sq8vps/vp-digi/(threads)

Thread 11 (2022-10-01):

300baud functionality

SQ9MDD, 2022-10-01:
Request to be able to change the operating speed to 300baud, which will allow operation on HF bands.
The tone shift is 200 Hz rather than the 1000 Hz used in 1200 baud packet.

sq8vps, 2023-10-05:
300 Baud Bell 103 modem added in version 2.0.0.

Closed 2023-10-05.

Thread 18 (2023-08-14):

Add precise measured current (mA) values to readme

DeflateAwning, 2023-08-14:
Can you measure the min and max current draw of this device? We're considering using it for a cubesat project, where we have very tight power draw requirements

sq8vps, 2023-08-16:
The Blue Pill has no current measurement circuit built-in, but it is perfectly possible to include a shunt resistor in series with power supply and measure voltage drop with some op-amp. Currently I'm rewriting the code and voltage measurement and embedding it in beacon is on my to-do list and will be added in next release.

DeflateAwning, 2023-09-12:
The microcontroller uses about 40-50 mA in our testing, if that's a piece of information you want to add to the documentation

sq8vps, 2025-08-10:
Added, thank you.

Closed 2025-08-10.

Thread 20 (2023-08-14):

Build error: `multiple definition of 'ax25Cfg'`

DeflateAwning, 2023-08-14:
I'm getting the following build error after converting to STM32CubeIDE v1.13.0:

```
C:/ST/STM32CubeIDE_1.13/STM32CubeIDE/plugins/com.st.stm32cube.ide.mcu.externaltools.gnu-tools-for-stm32.11.3.rel1.win32_1.1.0.202305231506/tools/bin/../lib/gcc/arm-none-eabi/11.3.1/../../../../arm-none-eabi/bin/ld.exe: ./Src/beacon.o:C:/Users/me/vp-digi/Debug/../Inc/ax25.h:45: multiple definition of `ax25Cfg'; ./Src/ax25.o:C:/Users/me/vp-digi/Debug/../Inc/ax25.h:45: first defined here
```

Any idea what's going on?

I'm curious why those variables are declared in the headers and not in the C files (and then declared as `extern`s)?

sq8vps, 2023-08-16:
There compiler is probably different and it does not allow such things. I am refactoring the code to get rid of these bugs

Closed 2023-08-30.

Thread 24 (2023-08-21):

Receiving commands appears to break when using a CrLf (\r\n) line ending

DeflateAwning, 2023-08-21:
Steps to reproduce:

1. Turn on device, flash. connect to UART1 with a 9600 uart-to-usb converter. Using RealTerm.
2. Send `monitor\n`, where `\n` means the newline character (and not those literal characters).
3. Send `version\n`. Everything works.
4. Send `version\n\r`. Everything works fine. This is a weird one that probably rarely happens.
5. Send `version\r`. Everything works fine.
6. Send `version\r\n`. Observe no response. Observe that device goes unresponsive.

It appears that after step 5, the device requires a reboot to function.

This isn't the worst bug, but thought it was worth pointing out. In the README or on your website, you should mention the expected EOL character (esp. if you don't fix this behaviour).

sq8vps, 2023-08-30:
Resolved in 1.3.0, or at least I was unable to reproduce the issue

Closed 2023-08-30.

Thread 34 (2023-10-13):

Add voltage measurement and coulomb counter

9M2IBR, 2023-10-13:
Hi, can you add voltage measurement and coulomb counter So it can transmit the Value in beacon. Its can very usefull for solar powered digipeater.

sq8vps, 2024-05-16:
I believe you would like to have a voltage measurement and some kind of battery drain measurement?

Thread 35 (2023-10-15):

Missing rs.h - vp-digi failed to build

t52ta6ek, 2023-10-15:
Greetings!

Using STM32 IDE 1.13.2, Windows 10.
Cloned repository and imported into IDE
When attempting to reproduce the build, fx25.c reports failed to compile because of missing header file rs.h .

arm-none-eabi-gcc "../Core/Src/stm32f1xx_hal_msp.c" -mcpu=cortex-m3 -std=gnu11 -g -DDEBUG -DENABLE_FX25 -DUSE_HAL_DRIVER -DSTM32F103xB -c -I../Core/Inc -I../Drivers/STM32F1xx_HAL_Driver/Inc -I../Drivers/STM32F1xx_HAL_Driver/Inc/Legacy -I../Drivers/CMSIS/Device/ST/STM32F1xx/Include -I../Drivers/CMSIS/Include -I../lwfec -I../USB_DEVICE/App -I../USB_DEVICE/Target -I../Middlewares/ST/STM32_USB_Device_Library/Core/Inc -I../Middlewares/ST/STM32_USB_Device_Library/Class/CDC/Inc -Og -ffunction-sections -fdata-sections -Wall -fstack-usage -fcyclomatic-complexity -MMD -MP -MF"Core/Src/stm32f1xx_hal_msp.d" -MT"Core/Src/stm32f1xx_hal_msp.o" --specs=nano.specs -mfloat-abi=soft -mthumb -o "Core/Src/stm32f1xx_hal_msp.o"
../Core/Src/fx25.c:24:10: fatal error: rs.h: No such file or directory
   24 | #include "rs.h"
      |          ^~~~~~
compilation terminated.

sq8vps, 2023-10-16:
Did you execute
```
git submodule init
git submodule update
```
before compilation, as specified in readme?

t52ta6ek, 2023-10-16:
Mea culpa! RTFM.
Build successful after completing git submodule steps... ;-)
tnx!

Closed 2023-10-16.

Thread 44 (2025-06-15):

AIOC build - USB serial device cannot start

tristanmoney, 2025-06-15:
Hi Piotr,

I am trying to test the AIOC with VP-Digi and I was able to build and flash but get the following error with the serial port:

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

Any idea why? I assume this USB serial port can to be used to configure VP-Digi or use it as a KISS TNC, just like like blue pill.

Thanks,

Tristan

tristanmoney, 2025-08-12:
I have version 1.11.5 of the STM32CubeF3 drivers and USB device library, if that matters. I think I tried an older version back in June but wasn't able to get it working.

Thread 45 (2025-07-06):

ax25.c broken for FX25

hiperiondev, 2025-07-06:
When enable FX25 in line 532:
	if(rx->rx != RX_STAGE_FX25_FRAME)
	{

this if have not close brace in the rest of code.

Gethub-prog, 2025-07-12:
Aprs using Baofeng 5RH pro can't be digitized on vpdigi, raw packets come in, but can't be digitized... I don't know if this is from the Baofeng firmware or from vpdigi

sq8vps, 2025-08-10:
Hi,
I'm pretty sure there is a closing bracket in line 614, which corresponds to the opening bracket in line 533 (FX.25) and line 599 (non-FX.25). Does this cause errors during compilation?
