sq8vps/vp-digi/Core/Src/main.c

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
/* Includes ------------------------------------------------------------------*/
#include "main.h"
#include "usb_device.h"
#include "gpio.h"

/* USER CODE BEGIN Includes */
#include <stdint.h>
#include "modem.h"
#include "ax25.h"
#include "digipeater.h"
#include "common.h"
#include "drivers/watchdog.h"
#include "beacon.h"
#include "terminal.h"
#include "config.h"
#include "uart.h"
#include "drivers/usb.h"
#include "kiss.h"
#ifdef ENABLE_FX25
#include "fx25.h"
#endif
/* USER CODE END Includes */


void SystemClock_Config(void);
/* USER CODE BEGIN 0 */
/**
 * @brief Handle received frame
 */
static void handleFrame(void)
{
	uint8_t modemBitmap = Ax25GetReceivedFrameBitmap(); // store states
	Ax25ClearReceivedFrameBitmap();

	uint8_t *buf;
	uint16_t size = 0;
	int8_t peak = 0;
	int8_t valley = 0;
	uint8_t signalLevel = 0;
	uint8_t fixed = 0;

	while (Ax25ReadNextRxFrame(&buf, &size, &peak, &valley, &signalLevel, &fixed))
	{
		if(DigiCheckFilter(&buf[7]) || !GeneralConfig.kissFilter)
			TermSendToAllN(MODE_KISS, buf, size);

		if ((UartUsb.mode == MODE_MONITOR)
#ifdef BLUE_PILL
		|| (Uart1.mode == MODE_MONITOR) 
		|| (Uart2.mode == MODE_MONITOR)
#endif
		)
		{
			char str[20];
			char *pstr = str;

			if(signalLevel > 70)
			{
				TermSendToAll(MODE_MONITOR, "\r\nInput level too high! Please reduce so most stations are around 30-50%.\r\n");
			}
			else if (signalLevel < 5)
			{
				TermSendToAll(MODE_MONITOR, "\r\nInput level too low! Please increase so most stations are around 30-50%.\r\n");
			}
#ifdef ENABLE_FX25
			if(fixed != AX25_NOT_FX25)
				TermSendToAll(MODE_MONITOR, "(FX.25)");
			else
#endif
				TermSendToAll(MODE_MONITOR, "(AX.25)");
			TermSendToAll(MODE_MONITOR, " Frame received [");
			for(uint8_t i = 0; i < ModemGetDemodulatorCount(); i++)
			{
				if (modemBitmap & (1 << i))
				{
					enum ModemPrefilter m = ModemGetFilterType(i);
					switch (m)
					{
						case PREFILTER_PREEMPHASIS:
							*pstr++ = 'P';
							break;
						case PREFILTER_DEEMPHASIS:
							*pstr++ = 'D';
							break;
						case PREFILTER_FLAT:
							*pstr++ = 'F';
							break;
						case PREFILTER_NONE:
							*pstr++ = 'N';
							break;
					}
				}
				else
					*pstr++ = '_';
			}
			*pstr++ = '\0';
			TermSendToAll(MODE_MONITOR, str);
			TermSendToAll(MODE_MONITOR, "], ");
#ifdef ENABLE_FX25
			if(fixed != AX25_NOT_FX25)
			{
				IntToStr(fixed, str);
				TermSendToAll(MODE_MONITOR, str);
				TermSendToAll(MODE_MONITOR, " bytes fixed, ");
			}
#endif
			TermSendToAll(MODE_MONITOR, "signal level ");
			IntToStr(signalLevel, str);
			TermSendToAll(MODE_MONITOR, str);
			TermSendToAll(MODE_MONITOR, "% (");
			IntToStr(peak, str);
			TermSendToAll(MODE_MONITOR, str);
			TermSendToAll(MODE_MONITOR, "%/");
			IntToStr(valley, str);
			TermSendToAll(MODE_MONITOR, str);
			TermSendToAll(MODE_MONITOR, "%): ");

			SendTNC2(buf, size);
			TermSendToAll(MODE_MONITOR, "\r\n");
		}

		DigiDigipeat(buf, size);
	}
}
/* USER CODE END 0 */

/**
  * @brief  The application entry point.
  * @retval int
  */
int main(void)
{

  /* MCU Configuration--------------------------------------------------------*/

  /* Reset of all peripherals, Initializes the Flash interface and the Systick. */
  HAL_Init();

  /* Configure the system clock */
  SystemClock_Config();

  /* USER CODE BEGIN SysInit */
	HAL_SetTickFreq(VPDIGI_HAL_TICK_FREQUENCY);

	USB_FORCE_REENUMERATION();
  /* USER CODE END SysInit */

  /* Initialize all configured peripherals */
  MX_GPIO_Init();
  MX_USB_DEVICE_Init();
  /* USER CODE BEGIN 2 */
	WdogInit(); // initialize watchdog

	memset(BeaconConfig, 0, sizeof(BeaconConfig));
	memset(&Ax25Config, 0, sizeof(Ax25Config));
	memset(&ModemConfig, 0, sizeof(ModemConfig));
	memset(&DigiConfig, 0, sizeof(DigiConfig));

	// set some initial values in case there is no configuration saved in memory
#ifdef BLUE_PILL
	Uart1.config.baudrate = 9600;
	Uart1.config.defaultMode = MODE_KISS;
	Uart2.config.baudrate = 9600;
	Uart2.config.defaultMode = MODE_KISS;
#endif
	UartUsb.config.defaultMode = MODE_KISS;
	ModemConfig.usePWM = 1; //use PWM in non-AIOC versions
	ModemConfig.flatAudioIn = 0; //no flat audio
	ModemConfig.pttOutput = 0; //primary PTT in AIOC versions
	ModemConfig.txLevel = 100; //100% - only in AIOC versions
	Ax25Config.quietTime = 300;
	Ax25Config.txDelayLength = 300;
	Ax25Config.txTailLength = 30;
	Ax25Config.fx25 = 0;
	DigiConfig.dupeTime = 30;

	ConfigRead();

	ModemInit();
	Ax25Init();
#ifdef ENABLE_FX25
	Fx25Init();
#endif

	DigiInitialize();

#ifdef BLUE_PILL
	UartInit(&Uart1, UART_LL_UART1_STRUCTURE, Uart1.config.baudrate);
	UartConfig(&Uart1, 1);
	UartInit(&Uart2, UART_LL_UART2_STRUCTURE, Uart2.config.baudrate);
	UartConfig(&Uart2, 1);
#endif

	UartInit(&UartUsb, NULL, 1);
	UartConfig(&UartUsb, 1);

	BeaconInit();
  /* USER CODE END 2 */

  /* Infinite loop */
  /* USER CODE BEGIN WHILE */
	while (1)
	{
    /* USER CODE END WHILE */

    /* USER CODE BEGIN 3 */
		WdogReset();

		if (Ax25GetReceivedFrameBitmap())
			handleFrame();

		DigiUpdateState(); // update digipeater state

		Ax25TransmitBuffer(); // transmit buffer (will return if nothing to be transmitted)

		Ax25TransmitCheck(); // check for pending transmission request

		if (UartUsb.rxType != DATA_NOTHING)
		{
			TermHandleSpecial(&UartUsb);
			if (UartUsb.rxType == DATA_KISS)
			{
				KissProcess(&UartUsb);
			}
			else if (UartUsb.rxType != DATA_USB)
			{

				TermParse(&UartUsb);
				UartClearRx(&UartUsb);
			}
			// previously there was just UartUsb.rxType = DATA_NOTHING, which could introduce deadlocks
			// assume that we were here, because rxType was DATA_USB, but in the meantime a new USB interrupt fired and rxType changed to DATA_KISS,
			// and the KISS parsing handler would set kissProcessingOngoing to 1. Then, we change rxType to DATA_NOTHING and are left in an incorrect scenario, when
			// rxType is DATA_NOTHING, and kissProcessingOngoing is 1, which is a clear deadlock, because then DATA_KISS can never be reached again.
			// That's why it is necessary to disable interrupts and check one more time for rxType before clearing it
			else
			{
				__disable_irq();
				if (UartUsb.rxType == DATA_USB)
					UartUsb.rxType = DATA_NOTHING;
				__enable_irq();
			}
		}
#ifdef BLUE_PILL
		if (Uart1.rxType != DATA_NOTHING)
		{
			if (Uart1.rxType == DATA_KISS)
			{
				KissProcess(&Uart1);
			}
			else
			{
				TermParse(&Uart1);
				UartClearRx(&Uart1);
			}
		}
		if (Uart2.rxType != DATA_NOTHING)
		{
			if (Uart2.rxType == DATA_KISS)
			{
				KissProcess(&Uart2);
			}
			else
			{
				TermParse(&Uart2);
				UartClearRx(&Uart2);
			}
		}
#endif

		BeaconCheck(); // check beacons

		if (HAL_GetTick() > 0xFFFFF000) // going to wrap around soon - hard reset the device
			NVIC_SystemReset();
	}
  /* USER CODE END 3 */
}

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
