sq8vps/vp-digi/Core/Src/modem.c

/*
Copyright 2020-2026 Piotr Wilkon
This file is part of VP-Digi.

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
You should have received a copy of the GNU General Public License
along with VP-Digi.  If not, see <http://www.gnu.org/licenses/>.
*/

#include <string.h>
#include <math.h>
#include "modem.h"
#include <stdlib.h>
#include <stdbool.h>
#include "ax25.h"
#include "common.h"
#include "drivers/modem_ll.h"
#include "filter.h"

/*
 * Configuration for PLL-based data carrier detection
 * 1. MAXPULSE - the maximum value of the DCD pulse counter. Higher values allow for more stability when a correct signal is detected,
 * but introduce a delay when releasing DCD
 * 2. THRES - the threshold value of the DCD pulse counter. When reached the input signal is assumed to be valid. Higher values mean more immunity to noise,
 * but introduce delay when setting DCD
 * 3. MAXPULSE and THRES difference sets the DCD "inertia" so that the DCD state won't change rapidly when a valid signal is present
 * 4. INC is the DCD pulse counter incrementation value when symbol changes near the PLL counter zero
 * 5. DEC is the DCD pulse counter decrementation value when symbol changes too far from PLL counter zero
 * 6. TUNE is the PLL counter tuning coefficient. It is applied when there is a symbol change (as the symbol change should occur when the PLL counter crosses zero)
 *
 * [       DCD OFF    *      |    DCD ON   ]
 * 0               COUNTER THRES        MAXPULSE
 *        <-DEC INC->
 *
 * The DCD mechanism is described in demodulate().
 * All values were selected by trial and error
 */
#define DCD1200_MAXPULSE 60
#define DCD1200_THRES 20
#define DCD1200_INC 2
#define DCD1200_DEC 1
#define DCD1200_TUNE 0.74f

#define DCD9600_MAXPULSE 60
#define DCD9600_THRES 40
#define DCD9600_INC 1
#define DCD9600_DEC 1
#define DCD9600_TUNE 0.74f

#define DCD300_MAXPULSE 80
#define DCD300_THRES 20
#define DCD300_INC 4
#define DCD300_DEC 1
#define DCD300_TUNE 0.74f

#define N1200 8 //samples per symbol @ fs=9600, oversampling = 38400 Hz
#define N9600 4 //fs=38400, oversampling = 153600 Hz
#define N300 32 //fs=9600, oversampling = 38400 Hz
#define NMAX 32 //keep this value equal to the biggest Nx

#define PLL1200_STEP (((uint64_t)1 << 32) / N1200) //PLL tick increment value
#define PLL9600_STEP (((uint64_t)1 << 32) / N9600)
#define PLL300_STEP (((uint64_t)1 << 32) / N300)

#define PLL1200_LOCKED_TUNE 0.74f
#define PLL1200_NOT_LOCKED_TUNE 0.50f
#define PLL9600_LOCKED_TUNE 0.89f
#define PLL9600_NOT_LOCKED_TUNE 0.50f //I have 0.67 noted somewhere as possibly better value
#define PLL300_LOCKED_TUNE 0.74f
#define PLL300_NOT_LOCKED_TUNE 0.50f

#define AMP_TRACKING_ATTACK 0.16f //0.16
#define AMP_TRACKING_DECAY 0.00004f //0.00004


#define DAC_SINE_SIZE 128 //DAC sine table size

#define PLL_TUNE_BITS 8 //number of bits when tuning PLL to avoid floating point operations

struct ModemDemodConfig ModemConfig;

static uint8_t N; //samples per symbol
static enum ModemTxTestMode txTestState; //current TX test mode
static uint8_t demodCount; //actual number of parallel demodulators
static sample_t dacSine[DAC_SINE_SIZE]; //sine samples for DAC
static uint8_t dacSineIdx; //current sine sample index
static volatile uint16_t samples[MODEM_LL_OVERSAMPLING_FACTOR]; //very raw received samples, filled directly by DMA
static uint8_t currentSymbol; //current symbol for NRZI encoding
static uint8_t scrambledSymbol; //current symbol after scrambling
static float markFreq; //mark frequency
static float spaceFreq; //space frequency
static float baudRate; //baudrate
static uint8_t markStep; //mark timer step
static uint8_t spaceStep; //space timer step
static uint16_t baudRateStep; //baudrate timer step
static sample_t coeffHiI[NMAX], coeffLoI[NMAX], coeffHiQ[NMAX], coeffLoQ[NMAX]; //correlator IQ coefficients
static uint8_t dcd = 0; //multiplexed DCD state from both demodulators
static uint32_t lfsr = 0xFFFFF; //LFSR for 9600 Bd
static int32_t adcBias = 4095; //ADC bias after decimation


struct DemodState
{
	uint8_t rawSymbols; //raw, unsynchronized symbols
	uint8_t syncSymbols; //synchronized symbols

	enum ModemPrefilter prefilter;
	struct Filter bpf;
	sample_t correlatorSamples[NMAX];
	uint8_t correlatorSamplesIdx;
	struct Filter lpf;

	uint8_t dcd : 1; //DCD state

	int32_t pll; //bit recovery PLL counter
	int32_t pllStep;
	int32_t pllLockedTune;
	int32_t pllNotLockedTune;

	int32_t dcdPll; //DCD PLL main counter
	uint8_t dcdLastSymbol; //last symbol for DCD
	uint16_t dcdCounter; //DCD "pulse" counter (incremented when RX signal is correct)
	uint16_t dcdMax;
	uint16_t dcdThres;
	uint16_t dcdInc;
	uint16_t dcdDec;
	int32_t dcdTune;

	sample_t peak;
	sample_t valley;
};

static struct DemodState demodState[MODEM_MAX_DEMODULATOR_COUNT];

static void decode(uint8_t symbol, uint8_t demod);
static sample_t demodulate(sample_t sample, struct DemodState *dem);
static void setPtt(bool state);


float ModemGetBaudrate(void)
{
	return baudRate;
}

uint8_t ModemGetDemodulatorCount(void)
{
	return demodCount;
}

uint8_t ModemDcdState(void)
{
	return dcd;
}

uint8_t ModemIsTxTestOngoing(void)
{
	if(txTestState != TEST_DISABLED)
		return 1;

	return 0;
}

void ModemGetSignalLevel(uint8_t modem, int8_t *peak, int8_t *valley, uint8_t *level)
{
#ifndef USE_FPU
	*peak = (100 * (int32_t)demodState[modem].peak) >> 12;
	*valley = (100 * (int32_t)demodState[modem].valley) >> 12;
	*level = (100 * (int32_t)(demodState[modem].peak - demodState[modem].valley)) >> 13;
#else
	*peak = 100.f * demodState[modem].peak;
	*valley = 100.f * demodState[modem].valley;
	*level = 50.f * (demodState[modem].peak - demodState[modem].valley);
#endif
}

enum ModemPrefilter ModemGetFilterType(uint8_t modem)
{
	return demodState[modem].prefilter;
}

/**
 * @brief Set DCD LED
 * @param[in] state False - OFF, true - ON
 */
static void setDcd(bool state)
{
	if(state)
		MODEM_LL_DCD_LED_ON();
	else
		MODEM_LL_DCD_LED_OFF();
}

static inline uint8_t descramble(uint8_t in)
{
	//G3RUH descrambling (x^17+x^12+1)
	uint8_t bit = ((lfsr & 0x10000) > 0) ^ ((lfsr & 0x800) > 0) ^ (in > 0);

	lfsr <<= 1;
	lfsr |= in;
	return bit;
}

static inline uint8_t scramble(uint8_t in)
{
	//G3RUH scrambling (x^17+x^12+1)
	uint8_t bit = ((lfsr & 0x10000) > 0) ^ ((lfsr & 0x800) > 0) ^ (in > 0);

	lfsr <<= 1;
	lfsr |= bit;
	return bit;
}

/**
 * @brief ISR for demodulator
 */
void MODEM_LL_DMA_INTERRUPT_HANDLER(void)
{
	 if(MODEM_LL_DMA_TRANSFER_COMPLETE_FLAG)
	 {
		 MODEM_LL_DMA_CLEAR_TRANSFER_COMPLETE_FLAG();

		//each sample is 12 bits, output sample is 13 bits (non-FPU)
		sample_t sample = (sample_t)((int32_t)((samples[0] + samples[1] + samples[2] + samples[3]) >> 1) - adcBias); //calculate input sample (decimation)
#ifdef USE_FPU
		sample *= (1.f / 4096.f);
#endif

		bool partialDcd = false;

		for(uint8_t i = 0; i < demodCount; i++)
		{
			uint8_t symbol = (demodulate(sample, (struct DemodState*)&demodState[i]) > 0); //demodulate sample
			decode(symbol, i); //recover bits, decode NRZI and call higher level function
			if(demodState[i].dcd)
				partialDcd = true;
		}

		if(partialDcd) //DCD on any of the demodulators
		{
			dcd = 1;
			setDcd(true);
		}
		else //no DCD on both demodulators
		{
			dcd = 0;
			setDcd(false);
		}
	}
}

/**
 * @brief ISR for pushing DAC samples
 */
 void MODEM_LL_DAC_INTERRUPT_HANDLER(void)
 {
	 MODEM_LL_DAC_TIMER_CLEAR_INTERRUPT_FLAG;

 	sample_t sample;

 	if(ModemConfig.modem == MODEM_9600)
 	{
#ifdef USE_FPU
 		sample = (sample_t)(scrambledSymbol ? 1.f : -1.f);
#else
		sample = (sample_t)(scrambledSymbol ? MODEM_LL_DAC_MAX : 0);
#endif
 		sample = filter(&demodState[0].lpf, sample);
 	}
 	else
 	{
 		sample = dacSine[dacSineIdx];
 		dacSineIdx++;
 		dacSineIdx %= DAC_SINE_SIZE;
 	}

#ifdef AIOC
 	sample = (sample * (sample_t)ModemConfig.txLevel) / (sample_t)100;
#endif

 	int32_t dacSample;
#ifdef USE_FPU
 	dacSample = ((sample + 1.f) * 0.5f) * (sample_t)MODEM_LL_DAC_MAX;
#else
 	dacSample = sample;
#endif

 	if(dacSample < 0)
 		dacSample = 0;
 	else if(dacSample > MODEM_LL_DAC_MAX)
 		dacSample = MODEM_LL_DAC_MAX;

 	MODEM_LL_DAC_PUT_VALUE(dacSample);
}


/**
 * @brief ISR for baudrate generator timer. NRZI encoding is done here.
 */
 void MODEM_LL_BAUDRATE_TIMER_INTERRUPT_HANDLER(void)
 {
	 MODEM_LL_BAUDRATE_TIMER_CLEAR_INTERRUPT_FLAG();

 	if(txTestState == TEST_DISABLED) //transmitting normal data
 	{
 		if(Ax25GetTxBit() == 0) //get next bit and check if it's 0
 		{
 			currentSymbol ^= 1; //change symbol - NRZI encoding
 		}
 		//if 1, no symbol change
 	}
 	else //transmit test mode
 	{
 		if(ModemConfig.modem == MODEM_9600)
 		{
 			scrambledSymbol ^= 1;
 			return;
 		}
 		currentSymbol ^= 1; //change symbol
 	}

 	if(ModemConfig.modem == MODEM_9600)
 	{
 		scrambledSymbol = scramble(currentSymbol);
 	}
 	else
 	{
 	 	MODEM_LL_DAC_TIMER_SET_CURRENT_VALUE(0);
 		if(currentSymbol)
 		{
 			MODEM_LL_DAC_TIMER_SET_RELOAD_VALUE(spaceStep);
 		}
 		else
 		{
 			MODEM_LL_DAC_TIMER_SET_RELOAD_VALUE(markStep);
 		}
 	}

}

/**
 * @brief Demodulate received sample (4x oversampling)
 * @param[in] sample Received sample, not more than 13 bits (non-FPU)
 * @param[in] *dem Demodulator state
 * @return Current tone (0 or 1)
 */
static sample_t demodulate(sample_t sample, struct DemodState *dem)
{
	//input signal amplitude tracking
#ifndef USE_FPU
	if(sample > dem->peak)
	{
		dem->peak += (((int32_t)(AMP_TRACKING_ATTACK * (float)32768) * (int32_t)(sample - dem->peak)) >> 15);
	}
	else
	{
		dem->peak += (((int32_t)(AMP_TRACKING_DECAY * (float)32768) * (int32_t)(sample - dem->peak)) >> 15);
	}

	if(sample < dem->valley)
	{
		dem->valley -= (((int32_t)(AMP_TRACKING_ATTACK * (float)32768) * (int32_t)(dem->valley - sample)) >> 15);
	}
	else
	{
		dem->valley -= (((int32_t)(AMP_TRACKING_DECAY * (float)32768) * (int32_t)(dem->valley - sample)) >> 15);
	}
#else
	if(sample > dem->peak)
	{
		dem->peak += ((sample_t)AMP_TRACKING_ATTACK * (sample - dem->peak));
	}
	else
	{
		dem->peak += ((sample_t)AMP_TRACKING_DECAY * (sample - dem->peak));
	}

	if(sample < dem->valley)
	{
		dem->valley -= ((sample_t)AMP_TRACKING_ATTACK * (dem->valley - sample));
	}
	else
	{
		dem->valley -= ((sample_t)AMP_TRACKING_DECAY * (dem->valley - sample));
	}
#endif


	if(ModemConfig.modem != MODEM_9600)
	{
		if(dem->prefilter != PREFILTER_NONE) //filter is used
		{
			dem->correlatorSamples[dem->correlatorSamplesIdx++] = filter(&dem->bpf, sample);
		}
		else //no pre/deemphasis
		{
			dem->correlatorSamples[dem->correlatorSamplesIdx++] = sample;
		}

		dem->correlatorSamplesIdx %= N;

		sample_t outLoI = 0, outLoQ = 0, outHiI = 0, outHiQ = 0; //output values after correlating

		for(uint8_t i = 0; i < N; i++)
		{
			sample_t t = dem->correlatorSamples[(dem->correlatorSamplesIdx + i) % N]; //read sample
			outLoI += t * coeffLoI[i]; //correlate sample
			outLoQ += t * coeffLoQ[i];
			outHiI += t * coeffHiI[i];
			outHiQ += t * coeffHiQ[i];
		}

#ifndef USE_FPU
		outHiI >>= 14;
		outHiQ >>= 14;
		outLoI >>= 14;
		outLoQ >>= 14;

		sample = (abs(outLoI) + abs(outLoQ)) - (abs(outHiI) + abs(outHiQ));
#else
		sample = (fabs(outLoI) + fabs(outLoQ)) - (fabs(outHiI) + fabs(outHiQ));
#endif

	}

	//DCD using "PLL"
	//PLL is running nominally at the frequency equal to the baudrate
	//PLL timer is counting up and eventually overflows to a minimal negative value
	//so it crosses zero in the middle
	//tone change should happen somewhere near this zero-crossing (in ideal case of exactly same TX and RX baudrates)
	//nothing is ideal, so we need to have some region around zero where tone change is expected
	//however in case of noise the demodulated output is completely random and has many symbol changes in different places
	//other than the PLL zero-crossing, thus making it easier to utilize this mechanism
	//if tone changed inside this region, then we add something to the DCD pulse counter and adjust counter phase for the counter to be closer to 0
	//if tone changes outside this region, then we subtract something from the DCD pulse counter
	//if some DCD pulse threshold is reached, then we claim that the incoming signal is correct and set DCD flag
	//when configured properly, it's generally immune to noise and sensitive to correct signal
	//it's also important to set some maximum value for DCD counter, otherwise the DCD is "sticky"


	dem->dcdPll = (int32_t)((uint32_t)(dem->dcdPll) + (uint32_t)(dem->pllStep)); //keep PLL ticking at the frequency equal to baudrate

	if((sample > 0) != dem->dcdLastSymbol) //tone changed
	{
		if((uint32_t)abs(dem->dcdPll) < (uint32_t)(dem->pllStep)) //tone change occurred near zero
		{
			dem->dcdCounter += dem->dcdInc; //increase DCD counter
			if(dem->dcdCounter > dem->dcdMax) //maximum DCD counter value reached
				dem->dcdCounter = dem->dcdMax; //avoid "sticky" DCD and counter overflow
		}
		else //tone change occurred far from zero
		{
			if(dem->dcdCounter >= dem->dcdDec) //avoid overflow
				dem->dcdCounter -= dem->dcdDec; //decrease DCD counter
			else
				dem->dcdCounter = 0;
		}

		//avoid floating point operations
		dem->dcdPll = ((int64_t)dem->dcdPll * (int64_t)dem->dcdTune) >> PLL_TUNE_BITS;
	}

	dem->dcdLastSymbol = sample > 0; //store last symbol for symbol change detection


	if(dem->dcdCounter > dem->dcdThres) //DCD threshold reached
		dem->dcd = 1; //DCD!
	else //below DCD threshold
		dem->dcd = 0; //no DCD

	return filter(&dem->lpf, sample) > 0;
}

/**
 * @brief Decode received symbol: bit recovery, NRZI decoding and pass the decoded bit to higher level protocol
 * @param[in] symbol Received symbol
 * @param demod Demodulator index
 */
static void decode(uint8_t symbol, uint8_t demod)
{
	struct DemodState *dem = (struct DemodState*)&demodState[demod];

	//This function provides bit/clock recovery and NRZI decoding
	//Bit recovery is based on PLL which is described in the function above (DCD PLL)
	//Current symbol is sampled at PLL counter overflow, so symbol transition should occur at PLL counter zero
	int32_t previous = dem->pll; //store last clock state

	dem->pll = (int32_t)((uint32_t)(dem->pll) + (uint32_t)(dem->pllStep)); //keep PLL running

	dem->rawSymbols <<= 1; //store received unsynchronized symbol
	dem->rawSymbols |= (symbol & 1);


	if ((dem->pll < 0) && (previous > 0)) //PLL counter overflow, sample symbol, decode NRZI and process in higher layer
	{
		dem->syncSymbols <<= 1;	//shift recovered (received, synchronized) bit register

		uint8_t sym = dem->rawSymbols & 0x07; //take last three symbols for sampling. Seems that 1 symbol is not enough, but 3 symbols work well
		if(sym == 0b111 || sym == 0b110 || sym == 0b101 || sym == 0b011) //if there are 2 or 3 ones, then the received symbol is 1
			sym = 1;
		else
			sym = 0;

		if(ModemConfig.modem == MODEM_9600)
			sym = descramble(sym); //descramble

		dem->syncSymbols |= sym;

		//NRZI decoding
		if (((dem->syncSymbols & 0x03) == 0b11) || ((dem->syncSymbols & 0x03) == 0b00)) //two last symbols are the same - no symbol transition - decoded bit 1
		{
			Ax25BitParse(1, demod);
		}
		else //symbol transition - decoded bit 0
		{
			Ax25BitParse(0, demod);
		}
	}

	if(((dem->rawSymbols & 0x03) == 0b10) || ((dem->rawSymbols & 0x03) == 0b01)) //if there was a symbol transition, adjust PLL
	{
		//avoid floating point operations. Multiply by n-bit value and shift by n bits
		if(!dem->dcd) //PLL not locked
		{
			dem->pll = ((int64_t)dem->pll * (int64_t)dem->pllNotLockedTune) >> PLL_TUNE_BITS; //adjust PLL faster
		}
		else //PLL locked
		{
			dem->pll = ((int64_t)dem->pll * (int64_t)dem->pllLockedTune) >> PLL_TUNE_BITS; //adjust PLL slower
		}
	}

}



void ModemTxTestStart(enum ModemTxTestMode type)
{
	 if(txTestState != TEST_DISABLED) //TX test is already running
	 	ModemTxTestStop(); //stop this test

	 setPtt(true); //PTT on
	 txTestState = type;

	 MODEM_LL_ADC_TIMER_DISABLE();
	 MODEM_LL_DAC_TIMER_ENABLE();

	 NVIC_DisableIRQ(MODEM_LL_DMA_IRQ);
	 NVIC_EnableIRQ(MODEM_LL_DAC_IRQ);

	 if(ModemConfig.modem == MODEM_9600)
	 {
		MODEM_LL_DAC_TIMER_SET_RELOAD_VALUE(markStep);
		MODEM_LL_BAUDRATE_TIMER_ENABLE();
		NVIC_EnableIRQ(MODEM_LL_BAUDRATE_TIMER_IRQ);
		return;
	 }

	 if(type == TEST_MARK)
	 {
		 MODEM_LL_DAC_TIMER_SET_RELOAD_VALUE(markStep);
	 }
	 else if(type == TEST_SPACE)
	 {
		 MODEM_LL_DAC_TIMER_SET_RELOAD_VALUE(spaceStep);
	 }
	 else //alternating tones
	 {
		MODEM_LL_BAUDRATE_TIMER_ENABLE();
	 	NVIC_EnableIRQ(MODEM_LL_BAUDRATE_TIMER_IRQ); //enable interrupt in NVIC
	 }
}


void ModemTxTestStop(void)
{
	 txTestState = TEST_DISABLED;

	 MODEM_LL_BAUDRATE_TIMER_DISABLE();
	 MODEM_LL_DAC_TIMER_DISABLE(); //disable DAC timer
	 MODEM_LL_ADC_TIMER_ENABLE(); //enable RX timer

	 NVIC_DisableIRQ(MODEM_LL_BAUDRATE_TIMER_IRQ);
	 NVIC_DisableIRQ(MODEM_LL_DAC_IRQ);
	 NVIC_EnableIRQ(MODEM_LL_DMA_IRQ);

	 setPtt(false); //PTT off
}


void ModemTransmitStart(void)
{
	 setPtt(true); //PTT on
	 if(ModemConfig.modem == MODEM_9600)
	 {
		 MODEM_LL_DAC_TIMER_SET_RELOAD_VALUE(markStep);
	 }

	 MODEM_LL_BAUDRATE_TIMER_ENABLE();
	 MODEM_LL_DAC_TIMER_ENABLE();
	 MODEM_LL_ADC_TIMER_DISABLE();

	 NVIC_DisableIRQ(MODEM_LL_DMA_IRQ);
	 NVIC_EnableIRQ(MODEM_LL_DAC_IRQ);
	 NVIC_EnableIRQ(MODEM_LL_BAUDRATE_TIMER_IRQ);
}


/**
 * @brief Stop TX and go back to RX
 */
void ModemTransmitStop(void)
{
	 MODEM_LL_ADC_TIMER_ENABLE();
	 MODEM_LL_DAC_TIMER_DISABLE();
	 MODEM_LL_BAUDRATE_TIMER_DISABLE();

	 NVIC_DisableIRQ(MODEM_LL_DAC_IRQ);
	 NVIC_DisableIRQ(MODEM_LL_BAUDRATE_TIMER_IRQ);
	 NVIC_EnableIRQ(MODEM_LL_DMA_IRQ);

	 setPtt(false);
}

/**
 * @brief Control PTT output
 * @param state False - PTT off, true - PTT on
 */
static void setPtt(bool state)
{
	 if(state)
	 {
	 	MODEM_LL_PTT_ON(ModemConfig.pttOutput);
	 }
	 else
	 {
	 	MODEM_LL_PTT_OFF(ModemConfig.pttOutput);
	 }
}


void ModemApplyRxGain(void)
{
#ifdef AIOC
	MODEM_LL_SET_GAIN(1 << ModemConfig.gain);
#endif
}

void ModemApplyTxAttenuator(void)
{
#ifdef AIOC
	MODEM_LL_SET_TX_ATTENUATOR(ModemConfig.attenuator);
#endif
}

void ModemInit(void)
{
	memset(demodState, 0, sizeof(demodState));

	MODEM_LL_INITIALIZE_RCC();

	MODEM_LL_INITIALIZE_OUTPUTS();

	volatile ADC_TypeDef *adc = MODEM_LL_INITIALIZE_ADC(&adcBias);

	MODEM_LL_INITIALIZE_DMA(samples, MODEM_LL_OVERSAMPLING_FACTOR, adc);

	NVIC_EnableIRQ(MODEM_LL_DMA_IRQ);

	MODEM_LL_INITIALIZE_DAC();

	MODEM_LL_ADC_TIMER_INITIALIZE();

	MODEM_LL_DAC_TIMER_INITIALIZE();

	MODEM_LL_BAUDRATE_TIMER_INITIALIZE();

	if(ModemConfig.modem > MODEM_9600)
	 ModemConfig.modem = MODEM_1200;

	if((ModemConfig.modem == MODEM_1200) || (ModemConfig.modem == MODEM_1200_V23))
	{
		//use one modem in FX.25 mode
		//FX.25 (RS) functions are not reentrant
		if(
#ifdef ENABLE_FX25
			Ax25Config.fx25
#else
			0
#endif
		)
			demodCount = 1;
		else

			demodCount = 2;
		N = N1200;
		baudRate = 1200.f;

		demodState[0].pllStep = PLL1200_STEP;
		demodState[0].pllLockedTune = PLL1200_LOCKED_TUNE * (float)((uint32_t)1 << PLL_TUNE_BITS);
		demodState[0].pllNotLockedTune = PLL1200_NOT_LOCKED_TUNE * (float)((uint32_t)1 << PLL_TUNE_BITS);
		demodState[0].dcdMax = DCD1200_MAXPULSE;
		demodState[0].dcdThres = DCD1200_THRES;
		demodState[0].dcdInc = DCD1200_INC;
		demodState[0].dcdDec = DCD1200_DEC;
		demodState[0].dcdTune = DCD1200_TUNE * (float)((uint32_t)1 << PLL_TUNE_BITS);

		demodState[1].pllStep = PLL1200_STEP;
		demodState[1].pllLockedTune = PLL1200_LOCKED_TUNE * (float)((uint32_t)1 << PLL_TUNE_BITS);
		demodState[1].pllNotLockedTune = PLL1200_NOT_LOCKED_TUNE * (float)((uint32_t)1 << PLL_TUNE_BITS);
		demodState[1].dcdMax = DCD1200_MAXPULSE;
		demodState[1].dcdThres = DCD1200_THRES;
		demodState[1].dcdInc = DCD1200_INC;
		demodState[1].dcdDec = DCD1200_DEC;
		demodState[1].dcdTune = DCD1200_TUNE * (float)((uint32_t)1 << PLL_TUNE_BITS);

		demodState[1].prefilter = PREFILTER_NONE;
		demodState[1].lpf.coeffs = lpf1200;
		demodState[1].lpf.taps = sizeof(lpf1200) / sizeof(*lpf1200);
		demodState[1].lpf.gainShift = 15;


		demodState[0].lpf.coeffs = lpf1200;
		demodState[0].lpf.taps = sizeof(lpf1200) / sizeof(*lpf1200);
		demodState[0].lpf.gainShift = 15;
		demodState[0].prefilter = PREFILTER_NONE;

		if(ModemConfig.flatAudioIn) //when used with flat audio input, use deemphasis and flat modems
		{
#ifdef ENABLE_FX25
			if(Ax25Config.fx25)
				demodState[0].prefilter = PREFILTER_NONE;
			else
#endif
				demodState[0].prefilter = PREFILTER_DEEMPHASIS;
			demodState[0].bpf.coeffs = bpf1200Inv;
			demodState[0].bpf.taps = sizeof(bpf1200Inv) / sizeof(*bpf1200Inv);
			demodState[0].bpf.gainShift = 15;

		}
		else //when used with normal (filtered) audio input, use flat and preemphasis modems
		{
			demodState[0].prefilter = PREFILTER_PREEMPHASIS;
			demodState[0].bpf.coeffs = bpf1200;
			demodState[0].bpf.taps = sizeof(bpf1200) / sizeof(*bpf1200);
			demodState[0].bpf.gainShift = 15;
		}

		if(ModemConfig.modem == MODEM_1200) //Bell 202
		{
			markFreq = 1200.f;
			spaceFreq = 2200.f;
		}
		else //V.23
		{
			markFreq = 1300.f;
			spaceFreq = 2100.f;
		}

	}
	else if(ModemConfig.modem == MODEM_300)
	{
		demodCount = 1;
		N = N300;
		baudRate = 300.f;
		markFreq = 1600.f;
		spaceFreq = 1800.f;

		demodState[0].pllStep = PLL300_STEP;
		demodState[0].pllLockedTune = PLL300_LOCKED_TUNE * (float)((uint32_t)1 << PLL_TUNE_BITS);
		demodState[0].pllNotLockedTune = PLL300_NOT_LOCKED_TUNE * (float)((uint32_t)1 << PLL_TUNE_BITS);
		demodState[0].dcdMax = DCD300_MAXPULSE;
		demodState[0].dcdThres = DCD300_THRES;
		demodState[0].dcdInc = DCD300_INC;
		demodState[0].dcdDec = DCD300_DEC;
		demodState[0].dcdTune = DCD300_TUNE * (float)((uint32_t)1 << PLL_TUNE_BITS);

		demodState[0].prefilter = PREFILTER_FLAT;
		demodState[0].bpf.coeffs = bpf300;
		demodState[0].bpf.taps = sizeof(bpf300) / sizeof(*bpf300);
		demodState[0].bpf.gainShift = 16;
		demodState[0].lpf.coeffs = lpf300;
		demodState[0].lpf.taps = sizeof(lpf300) / sizeof(*lpf300);
		demodState[0].lpf.gainShift = 15;
	}
	else if(ModemConfig.modem == MODEM_9600)
	{
		demodCount = 1;
		N = N9600;
		baudRate = 9600.f;
		markFreq = 38400.f / (float)DAC_SINE_SIZE; //use as DAC sample rate

		demodState[0].pllStep = PLL9600_STEP;
		demodState[0].pllLockedTune = PLL9600_LOCKED_TUNE * (float)((uint32_t)1 << PLL_TUNE_BITS);
		demodState[0].pllNotLockedTune = PLL9600_NOT_LOCKED_TUNE * (float)((uint32_t)1 << PLL_TUNE_BITS);
		demodState[0].dcdMax = DCD9600_MAXPULSE;
		demodState[0].dcdThres = DCD9600_THRES;
		demodState[0].dcdInc = DCD9600_INC;
		demodState[0].dcdDec = DCD9600_DEC;
		demodState[0].dcdTune = DCD9600_TUNE * (float)((uint32_t)1 << PLL_TUNE_BITS);

		demodState[0].prefilter = PREFILTER_NONE;
		//this filter will be used for RX and TX
		demodState[0].lpf.coeffs = lpf9600;
		demodState[0].lpf.taps = sizeof(lpf9600) / sizeof(*lpf9600);
		demodState[0].lpf.gainShift = 16;

	}

	MODEM_LL_ADC_SET_SAMPLE_RATE(baudRate * N * MODEM_LL_OVERSAMPLING_FACTOR);

	MODEM_LL_ADC_TIMER_ENABLE();

	markStep =  MODEM_LL_DAC_TIMER_CALCULATE_STEP(DAC_SINE_SIZE * markFreq);
	spaceStep = MODEM_LL_DAC_TIMER_CALCULATE_STEP(DAC_SINE_SIZE * spaceFreq);
	baudRateStep = MODEM_LL_BAUDRATE_TIMER_CALCULATE_STEP(baudRate);


	MODEM_LL_BAUDRATE_TIMER_SET_RELOAD_VALUE(baudRateStep);

	for(uint8_t i = 0; i < N; i++) //calculate correlator coefficients
	{
#ifdef USE_FPU
#define COEFF_SCALE 1.f
#else
#define COEFF_SCALE 4095.f
#endif
		coeffLoI[i] = cosf(2.f * 3.1416f * (float)i / (float)N * markFreq / baudRate) * COEFF_SCALE;
		coeffLoQ[i] = sinf(2.f * 3.1416f * (float)i / (float)N * markFreq / baudRate) * COEFF_SCALE;
		coeffHiI[i] = cosf(2.f * 3.1416f * (float)i / (float)N * spaceFreq / baudRate) * COEFF_SCALE;
		coeffHiQ[i] = sinf(2.f * 3.1416f * (float)i / (float)N * spaceFreq / baudRate) * COEFF_SCALE;
	}

	for(uint8_t i = 0; i < DAC_SINE_SIZE; i++) //calculate DAC sine samples
	{
#if defined(USE_FPU)
		dacSine[i] = (sinf(2.f * 3.1416f * (float)i / (float)DAC_SINE_SIZE));
#else
		dacSine[i] = ((sinf(2.f * 3.1416f * (float)i / (float)DAC_SINE_SIZE) + 1.f) * ((float)MODEM_LL_DAC_MAX / 2.f));
#endif
	}
}
