sq8vps/vp-digi/Core/Src/digipeater.c

/*
Copyright 2020-2026 Piotr Wilkon

This file is part of VP-Digi.

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
You should have received a copy of the GNU General Public License
along with VP-Digi.  If not, see <http://www.gnu.org/licenses/>.
*/

#include "digipeater.h"
#include "terminal.h"
#include <string.h>
#include "common.h"
#include "ax25.h"
#include <math.h>
#include "modem.h"
#include "drivers/digipeater_ll.h"
#include "aprs.h"

struct DigiConfig DigiConfig;

#define VISCOUS_MAX_FRAME_COUNT 10 //max frames in viscous-delay buffer
#define VISCOUS_MAX_FRAME_SIZE 150

struct ViscousData
{
	uint32_t hash;
	uint32_t timeLimit;
	uint8_t frame[VISCOUS_MAX_FRAME_SIZE];
	uint16_t size;
};
static struct ViscousData viscous[VISCOUS_MAX_FRAME_COUNT];
#define VISCOUS_HOLD_TIME 5000 //viscous-delay hold time in ms

struct DeDupeData
{
	uint32_t hash;
	uint32_t timeLimit;
};

#define DEDUPE_SIZE (50) //duplicate protection buffer size (number of hashes)
static struct DeDupeData deDupe[DEDUPE_SIZE]; //duplicate protection hash buffer
static uint8_t deDupeCount = 0; //duplicate protection buffer index


static uint8_t buf[AX25_FRAME_MAX_SIZE];

/**
 * @brief Check if frame with specified hash is already in viscous-delay buffer and delete it if so
 * @param[in] hash Frame hash
 * @return 0 if not in buffer, 1 if in buffer
 */
static uint8_t viscousCheckAndRemove(uint32_t hash)
{
    for(uint8_t i = 0; i < VISCOUS_MAX_FRAME_COUNT; i++)
    {
    	if(viscous[i].hash == hash) //matching hash
    	{
    		viscous[i].hash = 0; //clear slot
    		viscous[i].timeLimit = 0;
    		viscous[i].size = 0;
    		TermSendToAll(MODE_MONITOR, "Digipeated frame received, dropping old frame from viscous-delay buffer\r\n");
    		return 1;
    	}
    }
    return 0;
}



static void DigiViscousRefresh(void)
{
    if(DigiConfig.viscous == 0) //viscous digipeating disabled on every alias
    {
    	return;
    }

	for(uint8_t i = 0; i < VISCOUS_MAX_FRAME_COUNT; i++)
    {
    	if((viscous[i].timeLimit > 0) && (HAL_GetTick() >= viscous[i].timeLimit)) //it's time to transmit this frame
        {
            void *handle = NULL;
            if(NULL != (handle = Ax25WriteTxFrame(viscous[i].frame, viscous[i].size)))
            {
				if(GeneralConfig.kissMonitor) //monitoring mode, send own frames to KISS ports
				{
					TermSendToAllN(MODE_KISS, viscous[i].frame, viscous[i].size);
				}

				TermSendToAll(MODE_MONITOR, "(AX.25) Transmitting viscous-delayed frame: ");
				SendTNC2(viscous[i].frame, viscous[i].size);
				TermSendToAll(MODE_MONITOR, "\r\n");
            }

    		viscous[i].hash = 0; //clear slot
    		viscous[i].timeLimit = 0;
    		viscous[i].size = 0;
        }
    }
}

/**
 * @brief Compare callsign with specified call in call filter table - helper function.
 * @param *call Callsign
 * @param index Callsign filter table index
 * @return true if matched, false otherwise
 */
static bool compareFilterCall(const uint8_t *call, uint8_t index)
{
	for(uint8_t i = 0; i < 6; i++)
	{
		if((DigiConfig.callFilter[index][i] < 0xff) && ((call[i] >> 1) != DigiConfig.callFilter[index][i]))
			return false;
	}
	if((DigiConfig.callFilter[index][6] < 0xff) && (EXTRACT_SSID(call[6]) != DigiConfig.callFilter[index][6])) //special case for ssid
		return false;

	return true;
}

bool DigiCheckFilter(const uint8_t *call)
{
	//filter by call
	for(uint8_t i = 0; i < (sizeof(DigiConfig.callFilter) / sizeof(DigiConfig.callFilter[0])); i++)
	{
		if(compareFilterCall(call, i)) //if callsigns match...
		{
			if(DigiConfig.filterPolarity == 0)
				return false; //...and blacklist is enabled, drop the frame
			else
				return true; //...and whitelist is enabled, accept the frame
		}
	}
	//if callsign is not on the list...
	if((DigiConfig.filterPolarity) == 0)
		return true; //...and blacklist is enabled, accept the frame
	else
		return false; //...and whitelist is enabled, drop the frame
}


/**
 * @brief Produce and push digipeated frame to transmit buffer
 * @param[in] *frame Pointer to frame buffer
 * @param[in] elStart Index of the current path element very first byte
 * @param[in] len Frame length
 * @param[in] hash Frame hash
 * @param[in] alias Alias number: 0-3 - n-N aliases, 4-7 - simple aliases, 8 - own call
 * @param[in] simple If 1, it is a simple alias or should be treated as a simple alias
 * @param[in] n Number in n-N type alias, e.g. in WIDE2-1 n=2
 */
static void makeFrame(uint8_t *frame, uint16_t elStart, uint16_t len, uint32_t hash, uint8_t alias, uint8_t simple, uint8_t n)
{
    uint16_t _index = 0; //underlying index for buffer if not in viscous-delay mode
    uint8_t *buffer; //buffer to store frame being prepared
    uint16_t *index = &_index; //index in buffer
    uint8_t viscousSlot = 0; //viscous delay frame slot we will use

    if((alias < 8) && (DigiConfig.viscous & (1 << (alias)))) //viscous delay mode
    {
    	for(uint8_t i = 0; i < VISCOUS_MAX_FRAME_COUNT; i++)
        {
        	if(viscous[i].timeLimit == 0) //look for the first available slot
        	{
        		viscousSlot = i;
        		break;
        	}
        }

    	if((len + 7) > VISCOUS_MAX_FRAME_SIZE) //if frame length (+ 7 bytes for inserted call) is bigger than buffer size
    		return; //drop

    	buffer = viscous[viscousSlot].frame;
    	index = &(viscous[viscousSlot].size);
    	*index = 0;
    }
    else //normal mode
    {
    	if((uint16_t)sizeof(buf) < (len + 7))
    		return;
    	buffer = buf;
    }


    if((alias < 8) && ((DigiConfig.callFilterEnable >> alias) & 1))
    {
    	if(!DigiCheckFilter(&frame[7])) //push source callsign through the filter
    	{
    		TermSendToAll(MODE_MONITOR, "Frame dropped by the filter\r\n");
    		return;
    	}
    }
    uint8_t ssid = EXTRACT_SSID(frame[elStart + 6]); //store SSID (N)


    if(alias < 8)
    {
    	if((DigiConfig.viscous & (1 << (alias))) || (DigiConfig.directOnly & (1 << alias))) //viscous-delay or direct-only enabled
    	{
    		if(elStart != 14)
    			return; //this is not the very first path element, frame not received directly
    		if((alias <= 3) && (ssid != n))
    			return; //n-N type alias, but n is not equal to N, frame not received directly
    	}
    }

    if(simple) //if this is a simple alias, our own call or we treat n-N as a simple alias
    {
    	while(*index < len) //copy whole frame
    	{
    		buffer[*index] = frame[*index];
    		(*index)++;
    	}

    	if((alias == 8) || ((DigiConfig.traced & (1 << alias)) == 0)) //own call or untraced
    	{
    		buffer[elStart + 6] |= H_BIT; //add h-bit
    	}
    	else //not our call, but treat it as a simple alias
    	{
    		for(uint8_t i = 0; i < sizeof(GeneralConfig.call); i++) //replace with own call
    			buffer[elStart + i] = GeneralConfig.call[i];

    		buffer[elStart + 6] &= C_BIT; //clear everything but path end bit
    		buffer[elStart + 6] |= ENCODE_SSID(GeneralConfig.callSsid) | H_BIT; //insert ssid and h-bit
    	}
    }
    else //standard n-N alias
    {
    	while(*index < elStart) //copy all data before current path element
    	{
    		buffer[*index] = frame[*index];
    		(*index)++;
    	}

    	uint16_t shift = 0;

    	//insert own callsign to path if:
    	//1. this is a traced alias OR
    	//2. this is an untraced alias, but it is the very first hop (heard directly)
    	if((DigiConfig.traced & (1 << alias)) || ((ssid == n) && (elStart == 14)))
    	{
    		for(uint8_t i = 0; i < sizeof(GeneralConfig.call); i++) //insert own call
    			buffer[(*index)++] = GeneralConfig.call[i];

    		buffer[(*index)++] = ENCODE_SSID(GeneralConfig.callSsid) | H_BIT; //insert ssid and h-bit
    		shift = 7; //additional shift when own call is inserted
    	}

		while(*index < (len + shift)) //copy rest of the frame
    	{
    		buffer[*index] = frame[*index - shift];
    		(*index)++;
    	}

		buffer[elStart + shift + 6] -= 2; //decrement SSID in alias (2 because ssid is shifted left by 1)
		if(EXTRACT_SSID(buffer[elStart + shift + 6]) == 0) //if SSID is 0
		{
			buffer[elStart + shift + 6] |= H_BIT; //add h-bit
		}

    }

	if((alias < 8) && (DigiConfig.viscous & (1 << alias)))
	{
		viscous[viscousSlot].hash = hash;
    	viscous[viscousSlot].timeLimit = HAL_GetTick() + (VISCOUS_HOLD_TIME / SYSTICK_INTERVAL);
		TermSendToAll(MODE_MONITOR, "Saving frame for viscous-delay digipeating\r\n");
	}
	else
	{
		void *handle = NULL;
        if(NULL != (handle = Ax25WriteTxFrame(buffer, *index)))
        {
            DigiStoreDeDupe(buffer, *index);

			if(GeneralConfig.kissMonitor) //monitoring mode, send own frames to KISS ports
			{
				TermSendToAllN(MODE_KISS, buffer, *index);
			}

			TermSendToAll(MODE_MONITOR, "(AX.25) Digipeating frame: ");
			SendTNC2(buffer, *index);
			TermSendToAll(MODE_MONITOR, "\r\n");
        }
	}
}



void DigiDigipeat(uint8_t *frame, uint16_t len)
{
	if(!DigiConfig.enable || DIGIPEATER_LL_GET_DISABLE_STATE())
		return;

    uint16_t t = 13; //start from first byte that can contain path end bit
    while((frame[t] & C_BIT) == 0) //look for path end
    {
    	if((t + 7) >= len)
    		return;
        t += 7;
    }

    //calculate frame "hash"
    uint32_t hash = Crc32(CRC32_INIT, frame, 14); //use destination and source address, skip path
    hash = Crc32(hash, &frame[t + 1], len - t - 1); //continue through all remaining data

    if(DigiConfig.viscous) //viscous-delay enabled on any slot
    {
    	if(viscousCheckAndRemove(hash)) //check if this frame was received twice
    		return; //if so, drop it
    }

    for(uint8_t i = 0; i < DEDUPE_SIZE; i++) //check if frame is already in duplicate filtering buffer
    {
        if(deDupe[i].hash == hash)
        {
            if(HAL_GetTick() < (deDupe[i].timeLimit))
            	return; //filter out duplicate frame
        }
    }


    if(t == 13) //path end bit in source address, no path in this frame
    {
        return; //drop it
    }


    while((frame[t] & H_BIT) == 0) //look for h-bit
    {
        if(t == 13)
        {
            break; //no h-bit found and we are in source address, we can proceed with the first path element
        }
        t -= 7; //look backwards for h-bit
    }
    t++; //now t is the index for the first byte in path element we want to process

    uint8_t ssid = EXTRACT_SSID(frame[t + 6]); //current path element SSID

    uint8_t err = 0;

    for(uint8_t i = 0; i < sizeof(GeneralConfig.call); i++) //compare with our call
    {
    	if(frame[t + i] != GeneralConfig.call[i])
    	{
    		err = 1;
    		break;
    	}
    }
    if(ssid != GeneralConfig.callSsid) //compare SSID also
    	err = 1;

    if(err == 0) //our callsign is in the path
    {
    	makeFrame(frame, t, len, hash, 8, 1, 0);
    	return;
    }

    for(uint8_t i = 0; i < 4; i++) //check for simple alias match
    {
        err = 0;
    	for(uint8_t j = 0; j < sizeof(DigiConfig.alias[0]); j++)
        {
        	if(frame[t + j] != DigiConfig.alias[i + 4][j])
        	{
            	err = 1;
            	break;
        	}
        }
        if(ssid != DigiConfig.ssid[i])
        	err = 1;

        if(err == 0) //no error
        {
        	makeFrame(frame, t, len, hash, i + 4, 1, 0);
        	return;
        }
    }

    //n-N style alias handling

    for(uint8_t i = 0; i < 4; i++)
    {
        err = 0;
        uint8_t j = 0;
    	for(; j < strlen((const char *)DigiConfig.alias[i]); j++)
        {
            if(frame[t + j] != DigiConfig.alias[i][j]) //check for matching alias
            {
                err = 1; //alias not matching
                break;
            }
        }

        if(err == 0) //alias matching, check further
        {
            uint8_t n = ((frame[t + j] >> 1) - '0'); //get n from alias (e.g. WIDEn-N) - N is in ssid variable

            //every path must meet several requirements
            //say we have a WIDEn-N path. Then:
            //N <= n
            //0 < n < 8
            //0 < N < 8
            if(((ssid > 0) && (ssid < 8) && (n > 0) && (n < 8) && (ssid <= n)) == 0) //path is broken or already used (N=0)
            	return;

            //check if n and N <= digi max
            if((n <= DigiConfig.max[i]) && (ssid <= DigiConfig.max[i]))
            {
                if(DigiConfig.enableAlias & (1 << i))
                	makeFrame(frame, t, len, hash, i, 0, n); //process as a standard n-N frame
            }
            else if((DigiConfig.rep[i] > 0) && (n >= DigiConfig.rep[i])) //else check if n and N >= digi replace
            {
                if(DigiConfig.enableAlias & (1 << i))
                	makeFrame(frame, t, len, hash, i, 1, n);
            }
        }
    }


}



void DigiStoreDeDupe(uint8_t *buf, uint16_t size)
{
	uint32_t hash = Crc32(CRC32_INIT, buf, 14); //calculate for destination and source address

    uint16_t i = 13;

    while((buf[i] & C_BIT) == 0) //look for path end bit (skip path)
    {
        i++;
        if(i == size)
        	return;
    }
    i++;

    hash = Crc32(hash, &buf[i], size - i);

    deDupeCount %= DEDUPE_SIZE;

    deDupe[deDupeCount].hash = hash;
    deDupe[deDupeCount].timeLimit = HAL_GetTick() + (DigiConfig.dupeTime * 1000 / SYSTICK_INTERVAL);

    deDupeCount++;
}

void DigiInitialize(void)
{
	DIGIPEATER_LL_INITIALIZE_RCC();
	DIGIPEATER_LL_INITIALIZE_INPUTS_OUTPUTS();
}

void DigiUpdateState(void)
{
	if(DigiConfig.enable)
	{
		if(DIGIPEATER_LL_GET_DISABLE_STATE())
		{
			DIGIPEATER_LL_LED_OFF();
		}
		else
		{
			DIGIPEATER_LL_LED_ON();
		}
	}
	else
	{
		DIGIPEATER_LL_LED_OFF();
	}

	DigiViscousRefresh();
}
