sq8vps/vp-digi/Core/Inc/common.h

/*
Copyright 2020-2026 Piotr Wilkon

This file is part of VP-Digi.

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
You should have received a copy of the GNU General Public License
along with VP-Digi.  If not, see <http://www.gnu.org/licenses/>.
*/

#ifndef COMMON_H_
#define COMMON_H_

#include <stdint.h>
#include "uart.h"

#if defined(STM32F103xB) || defined(STM32F103x8)
#include "stm32f1xx_hal.h"
#elif defined(STM32F302xC)
#include "stm32f3xx_hal.h"
#endif

#define VPDIGI_HAL_TICK_FREQUENCY HAL_TICK_FREQ_100HZ /**< Systick frequency for HAL. Use this to change systick frequency */

#if VPDIGI_HAL_TICK_FREQUENCY == HAL_TICK_FREQ_100HZ
#define SYSTICK_INTERVAL (10)
#elif VPDIGI_HAL_TICK_FREQUENCY == HAL_TICK_FREQ_10HZ
#define SYSTICK_INERVAL (100)
#elif VPDIGI_HAL_TICK_FREQUENCY == HAL_TICK_FREQ_1KHZ
#define SYSTICK_INTERVAL (1)
#else
#error Wrong systick frequency!
#endif

#define SYSTICK_FREQUENCY (1000 / SYSTICK_INTERVAL)

#define IS_UPPERCASE_ALPHANUMERIC(x) ((((x) >= '0') && ((x) <= '9')) || (((x) >= 'A') && ((x) <= 'Z')))
#define IS_NUMBER(x) (((x) >= '0') && ((x) <= '9'))
#define ABS(x) (((x) > 0) ? (x) : (-x))

#define CRC32_INIT 0xFFFFFFFF

struct GeneralConfig
{
	uint8_t call[6]; //device callsign
	uint8_t callSsid; //device ssid
	uint8_t dest[7]; //destination address for own beacons. Should be APNV01-0 for Blue Pill VP-Digi and APNV02-0 for AIOC VP-Digi, but can be changed. SSID MUST remain 0.
	uint8_t kissMonitor; //monitor own frames on KISS
	uint8_t kissFilter; //apply filtering to received frames on KISS
};

extern struct GeneralConfig GeneralConfig;

extern const char versionString[]; //version string


/**
 * @brief Generate random number from min to max
 * @param[in] min Lower boundary
 * @param[in] max Higher boundary
 * @return Generated number
 */
int16_t Random(int16_t min, int16_t max);

/**
 * @brief Convert string to int
 * @param[in] *str Input string
 * @param[in] len String length or 0 to detect by strlen()
 * @return Converted int
 */
int64_t StrToInt(const char *str, uint16_t len);

/**
 * @brief Convert int to string
 * @param n Number to convert
 * @param *str Target string buffer
 * @return Pointer to the null character following the written data
 * @note The buffer must be at least 9 bytes long
 */
char *IntToStr(int32_t n, char *str);

/**
 * @brief Convert AX25 frame to TNC2 (readable) format and send it through available ports
 * @param *from Input AX25 frame
 * @param len Input frame length
 */
void SendTNC2(uint8_t *from, uint16_t len);

/**
 * @brief Calculate CRC32
 * @param[in] crc0 Initial or current CRC value
 * @param[in] *s Input data
 * @param[in] n Input data length
 * @return Calculated CRC32
 */
uint32_t Crc32(uint32_t crc0, uint8_t *s, uint64_t n);

/**
 * @brief Check if callsign is correct and convert it to AX.25 format
 * @param *in Input ASCII callsign
 * @param size Input size, not bigger than 6
 * @param *out Output buffer, exactly 6 bytes
 * @return True if callsign is valid
 */
bool ParseCallsign(const char *in, uint16_t size, uint8_t *out);

/**
 * @brief Check if callsign with SSID is correct and convert it to AX.25 format
 * @param *in Input ASCII callsign with SSID
 * @param size Input size
 * @param *out Output buffer, exactly 6 bytes
 * @param *ssid Output SSID, exactly 1 byte
 * @return True if callsign is valid
 */
bool ParseCallsignWithSsid(const char *in, uint16_t size, uint8_t *out, uint8_t *ssid);

/**
 * @brief Check if SSID is correct and convert it to uint8_t
 * @param *in Input ASCII SSID
 * @param size Input size
 * @param *out Output buffer, exactly 1 byte
 * @return True if SSID is valid
 */
bool ParseSsid(const char *in, uint16_t size, uint8_t *out);

#endif /* COMMON_H_ */
