sq8vps/vp-digi/Core/Src/beacon.c

/*
Copyright 2020-2023 Piotr Wilkon

This file is part of VP-Digi.

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
You should have received a copy of the GNU General Public License
along with VP-Digi.  If not, see <http://www.gnu.org/licenses/>.
*/

#include "beacon.h"
#include "digipeater.h"
#include "common.h"
#include <string.h>
#include <systick.h>
#include "ax25.h"
#include "terminal.h"

struct Beacon beacon[8];

static uint32_t beaconDelay[8] = {0};
static uint8_t buf[150]; //frame buffer

/**
 * @brief Send specified beacon
 * @param[in] no Beacon number (0-7)
 */
void BeaconSend(uint8_t number)
{
	if(beacon[number].enable == 0)
		return; //beacon disabled

	uint16_t idx = 0;

	for(uint8_t i = 0; i < sizeof(GeneralConfig.dest); i++) //add destination address
		buf[idx++] = GeneralConfig.dest[i];

	for(uint8_t i = 0; i < sizeof(GeneralConfig.call); i++) //add source address
		buf[idx++] = GeneralConfig.call[i];

	buf[idx++] = ((GeneralConfig.callSsid << 1) + 0b01100000); //add source ssid

	if(beacon[number].path[0] > 0) //this beacon has some path set
	{
		for(uint8_t i = 0; i < 14; i++) //loop through path
		{
			if((beacon[number].path[i] > 0) || (i == 6) || (i == 13)) //normal data, not a NULL symbol
			{
				buf[idx] = beacon[number].path[i]; //copy path
				if((i == 6) || (i == 13)) //it was and ssid
				{
					buf[idx] = ((buf[idx] << 1) + 0b01100000); //add appropriate bits for ssid
				}
				idx++;
			}
			else //NULL in path
				break; //end here
		}
	}
	buf[idx - 1] |= 1; //add c-bit on the last element
	buf[idx++] = 0x03; //control
	buf[idx++] = 0xF0; //pid
	for(uint8_t i = 0; i < strlen((char*)beacon[number].data); i++)
	{
		buf[idx++] = beacon[number].data[i]; //copy beacon comment
	}

	void *handle = NULL;
	if(NULL != (handle = Ax25WriteTxFrame(buf, idx))) //try to write frame to TX buffer
	{
        if(GeneralConfig.kissMonitor) //monitoring mode, send own frames to KISS ports
        {
        	TermSendToAll(MODE_KISS, buf, idx);
        }

		DigiStoreDeDupe(buf, idx); //store frame hash in duplicate protection buffer (to prevent from digipeating own packets)

		TermSendToAll(MODE_MONITOR, (uint8_t*)"(AX.25) Transmitting beacon ", 0);

		TermSendNumberToAll(MODE_MONITOR, number);
		TermSendToAll(MODE_MONITOR, (uint8_t*)": ", 0);
		SendTNC2(buf, idx);
		TermSendToAll(MODE_MONITOR, (uint8_t*)"\r\n", 0);
	}

}

/**
 * @brief Check if any beacon should be transmitted and transmit if necessary
 */
void BeaconCheck(void)
{
	for(uint8_t i = 0; i < 8; i++)
	{
		if(beacon[i].enable == 0)
			continue;

		if((beacon[i].interval > 0) && ((SysTickGet() >= beacon[i].next) || (beacon[i].next == 0)))
		{
			if(beaconDelay[i] > SysTickGet()) //check for beacon delay (only for the very first transmission)
				continue;
			beacon[i].next = SysTickGet() + beacon[i].interval; //save next beacon timestamp
			beaconDelay[i] = 0;
			BeaconSend(i);
		}
	}
}


/**
 * @brief Initialize beacon module
 */
void BeaconInit(void)
{
	for(uint8_t i = 0; i < 8; i++)
	{
		beaconDelay[i] = (beacon[i].delay * SYSTICK_FREQUENCY) + SysTickGet() + (30000 / SYSTICK_INTERVAL); //set delay for beacons and add constant 30 seconds of delay
		beacon[i].next = 0;
	}
}
