sq8vps/vp-digi/(commit log)

2022-08-12 fix kiss rx bug
    [common.c, main.c, terminal.c, uart.c, uart.h]
2022-11-05 dest address set, pwm defaulting to 50 pcnt
2023-07-11 Update config.h
    Error in line 48.
    This error causes data beacons 6 and 7 to be written incorrectly.
    Great job!
    vy 73
    SQ9KCU
    [config.h]
2023-07-12 Update config.h
    Bug in line 48.
    This error causes data beacons 6 and 7 to be written incorrectly. Great job!
    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
    [config.h]
2023-07-12 Update beacon.c
    Small bug in beacon.c.
    If beacon for example 4 is turned off, beacons 4,5,6,7 do not work.
    The fix fixes the problem.
    vy73
    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
    [beacon.c]
2023-07-12 small bug in beacon.c
    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
    [beacon.c]
2023-07-29 non-aprs switch
2023-08-18 ax25 send, removed all mallocs
    [vp-digi Debug.cfg, vp-digi Release.cfg]
2023-08-29 initial kicad files
    [vp-digi.sch]
2023-08-29 beacon send bug fix and copyrights
    [ax25.c, ax25.h, beacon.c, beacon.h, common.c, common.h, config.c, config.h]
2023-08-30 non-aprs config bug, pwm by default
    [common.c, config.c, main.c]
2023-08-31 timer frq change, hamming distance using built-in fun
2023-09-04 tnc2 converter bug fix
    [common.c, kiss.c]
2023-09-05 fixed non-APRS RX problem
    [ax25.c]
2023-09-07 setting uart default modes
2023-09-08 moved to stm32cubeide, new hal version, uart bug fix
    [F103C8T6_DIGI_USB Debug.cfg, F103C8T6_DIGI_USB Release.cfg]
2024-05-16 default uart config, backspace handling
2024-05-16 default uart params and backspace handling
2024-12-04 KISS RX locking fixed?
    [ax25.h, common.c, kiss.c, uart.h]
2025-03-04 digi active led and disable switch, kiss tx deadlock resolved hopefully
    [common.c, digipeater.c, digipeater.h, main.c, uart.c]
2025-08-10 add current consumption summary
2025-08-10 add current consumption
2026-08-28 kiss filter + code cleanup
